hmmnice/learning-based-continuum-robot-IK/cad/robot-hook.stl

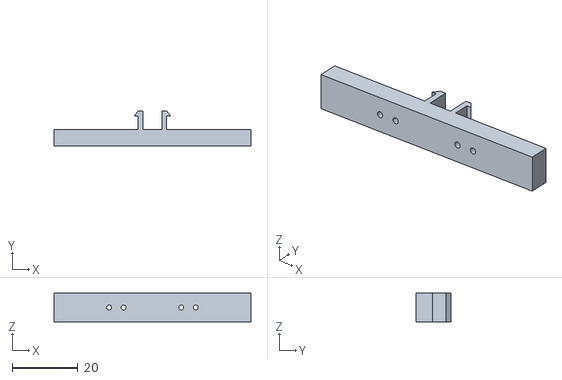
[picture p11: CAD file, 2026-06-19]
cad/robot-hook.stl
60.0 x 10.6 x 8.80
