hmmnice/learning-based-continuum-robot-IK/cad/TDCR-PROTO-WITH-BACKBONE_fixed.stl

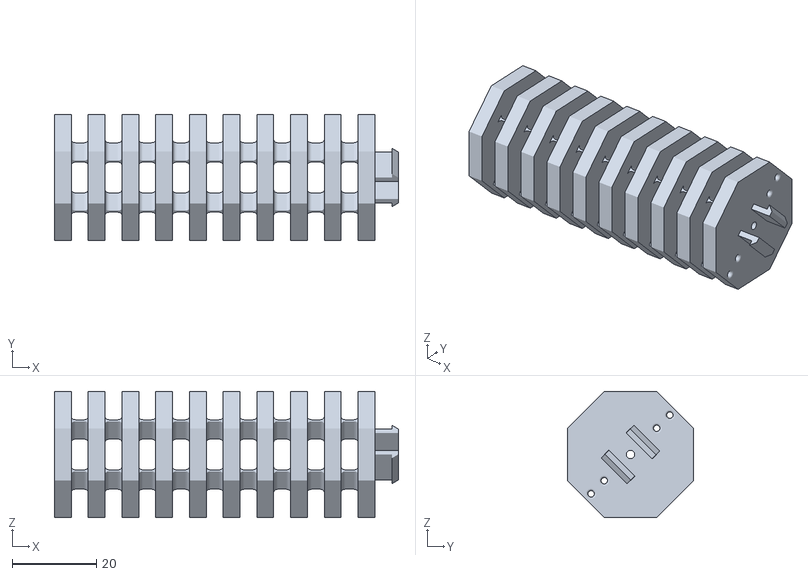
[picture p12: CAD file, 2026-06-19]
cad/TDCR-PROTO-WITH-BACKBONE_fixed.stl
81.6 x 30.0 x 30.0
