hmmnice/learning-based-continuum-robot-IK/cad/mounting-stand-v3.stl

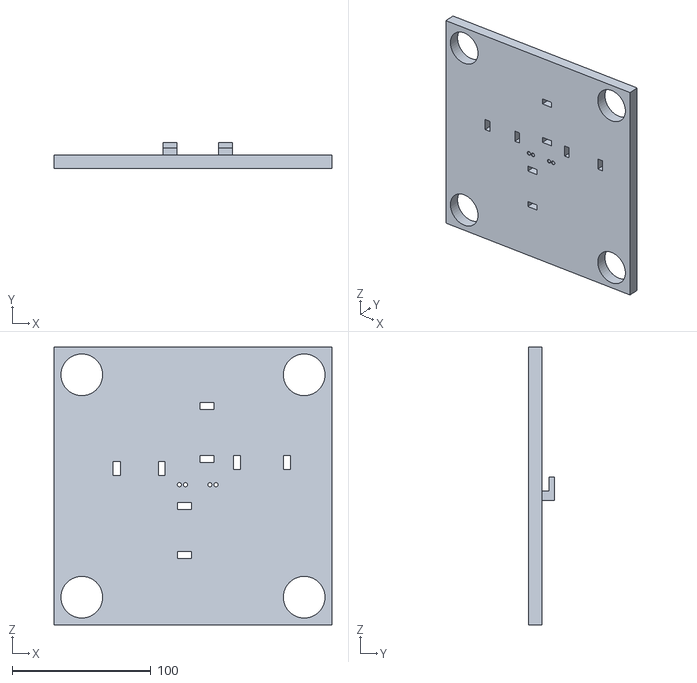
[picture p13: CAD file, 2026-06-19]
cad/mounting-stand-v3.stl
200.0 x 19.0 x 200.0
