hmmnice/learning-based-continuum-robot-IK/cad/stand-leg.stl

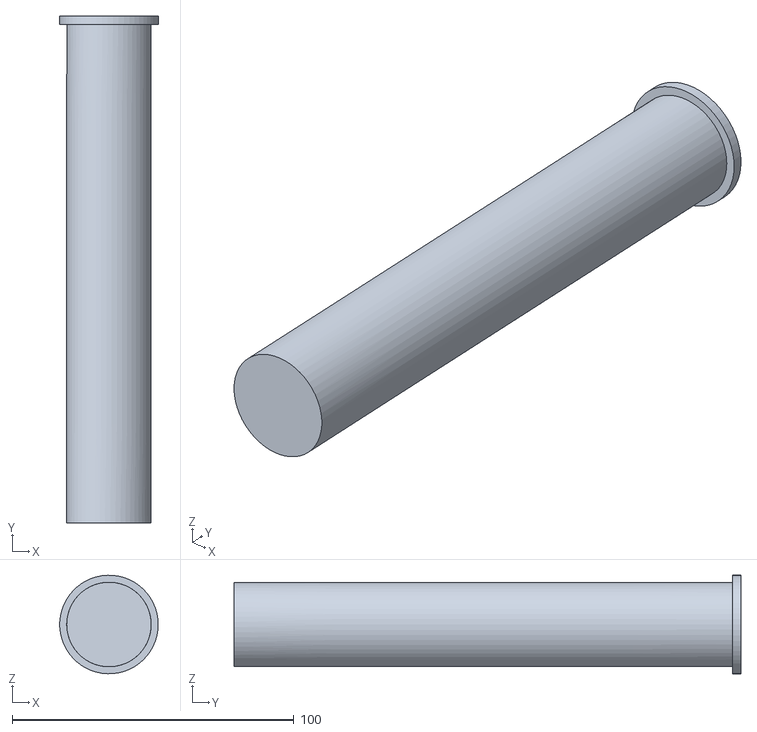
[picture p14: CAD file, 2026-06-19]
cad/stand-leg.stl
35.0 x 180.0 x 35.0
