hmmnice/learning-based-continuum-robot-IK/cad/motor-spool.stl

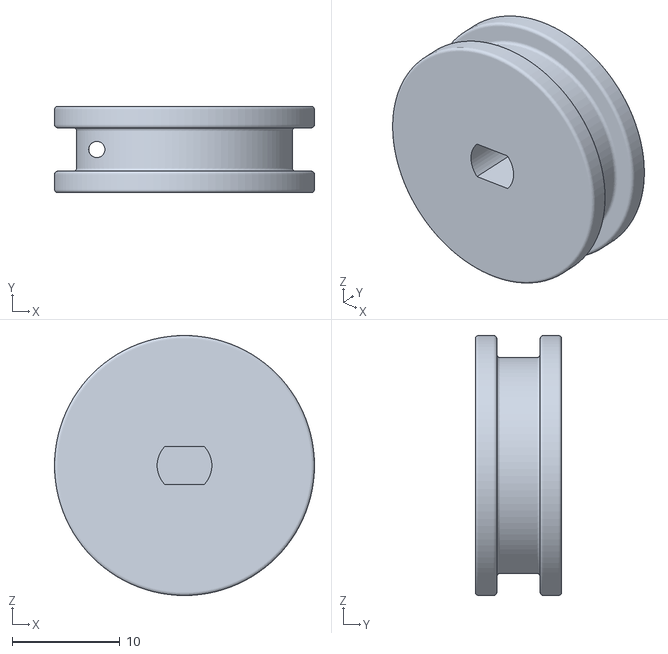
[picture p15: CAD file, 2026-06-19]
cad/motor-spool.stl
24.1 x 8.00 x 24.1
