hmmnice/learning-based-continuum-robot-IK/(commit log)

2026-06-19 added cad stl files that i worked on
    [TDCR-PROTO-WITH-BACKBONE_fixed.stl, motor-spool.stl, mounting-stand-v3.stl, robot-hook.stl, stand-leg.stl]
2026-06-19 Update README
    Corrected the description of the controller from 'Arduino-based' to 'ESP32 based' and updated file paths in the directory structure.
